BenK3nobi/Bmaps/VSR-V-1.0/drawing2.dxf

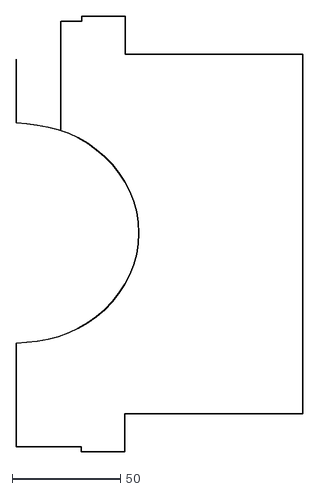
[picture p2: CAD file, 2019-07-29]
VSR-V-1.0/drawing2.dxf
132.3 x 200.8
