BenK3nobi/Bmaps/VSR-V-1.0/Holder/Holder.fcstd

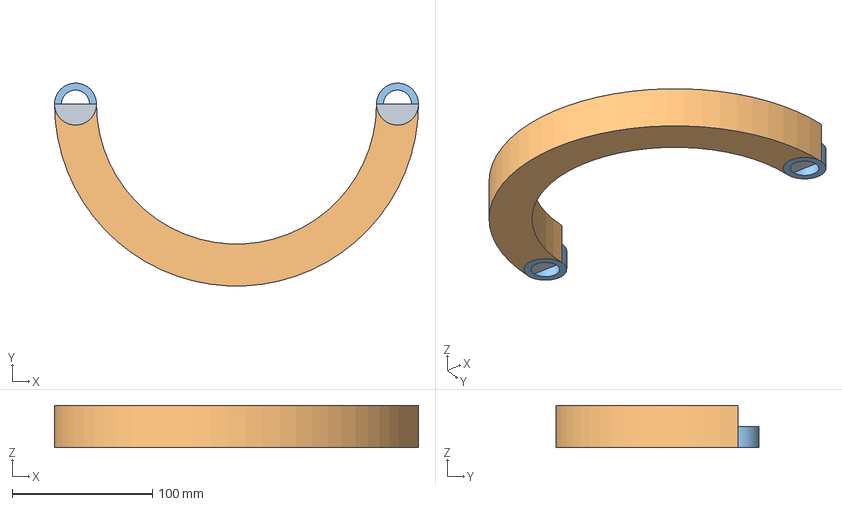
[picture p4: CAD file, 2019-07-29]
VSR-V-1.0/Holder/Holder.fcstd
260.0 x 144.8 x 30.0 mm
