BenK3nobi/Bmaps/(list of files, cad)

Other CAD files:
VSR-V-1.0/BoardStep.step
TESLA-V-1.0/BoardStep.step
TESLA-V-1.1/BoardStep.step
