BenK3nobi/Bmaps/VSR-V-1.0/AMR_3D_VSR_SingleCell.kicad_pcb

## KiCad design VSR-V-1.0/AMR_3D_VSR_SingleCell.kicad_pcb (2019-07-29)

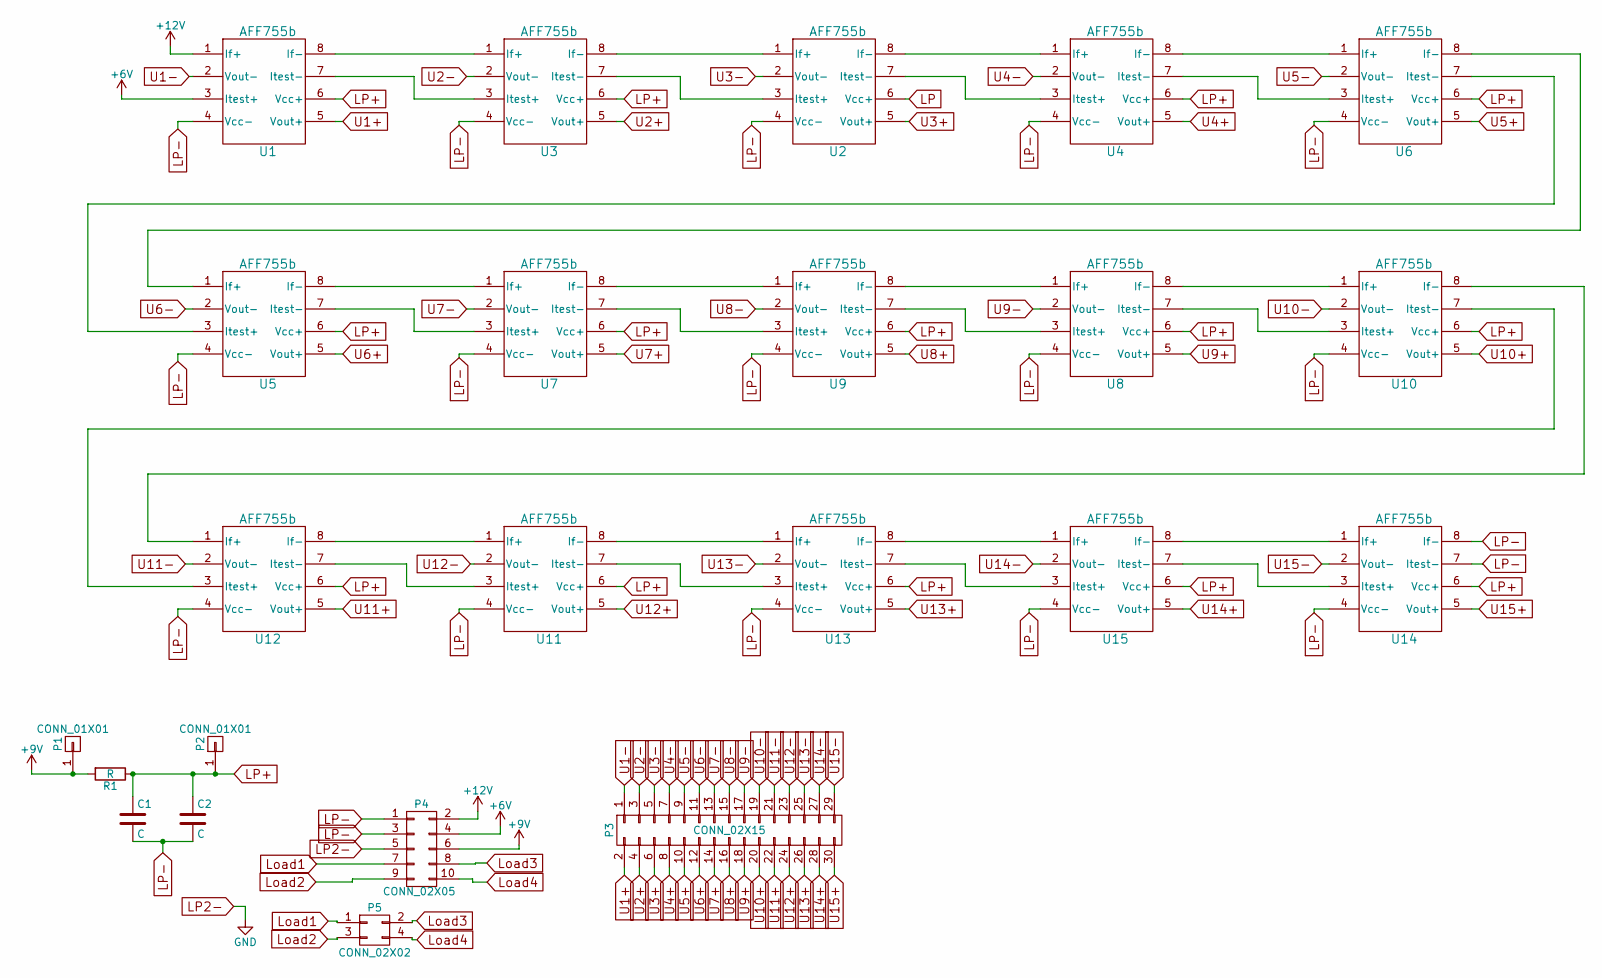
[picture p5: schematic AMR_3D_VSR_SingleCell.sch]

Parts:
C1, C2: C; SMD-2512_Pol
P1, P2: CONN_01X01; Pin_Header_Straight_1x01
P3: CONN_02X15; Multicomp_MC9A22-3434_2x17x2.54mm_Angled
P4: CONN_02X05; Multicomp_MC9A22-1034_2x05x2.54mm_Angled
P5: CONN_02X02; Pin_Header_Straight_2x02
R1: R; Resistor_Horizontal_RM10mm
U1, U2, U3, U4, U5, U6, U7, U8, U9, U10, U11, U12, U13, U14, U15: AFF755b; DIP-8_W7.62mm

Connections:
+6V: P4.4, U1.3 (Itest+)
+9V: P1.1, P4.6, R1.2
+12V: P4.2, U1.1 (If+)
Load1: P3.31, P4.7, P5.1; also elsewhere on the board
Load2: P3.33, P4.9, P5.3; also elsewhere on the board
Load3: P3.32, P4.8, P5.2; also elsewhere on the board
Load4: P3.34, P4.10, P5.4; also elsewhere on the board
unnamed: U1.7 (Itest-), U3.3 (Itest+)
unnamed: U1.8 (If-), U3.1 (If+)
unnamed: U2.1 (If+), U3.8 (If-)
unnamed: U2.3 (Itest+), U3.7 (Itest-)
unnamed: U2.7 (Itest-), U4.3 (Itest+)
unnamed: U2.8 (If-), U4.1 (If+)
unnamed: U4.7 (Itest-), U6.3 (Itest+)
unnamed: U4.8 (If-), U6.1 (If+)
unnamed: U5.1 (If+), U6.8 (If-)
unnamed: U5.3 (Itest+), U6.7 (Itest-)
unnamed: U5.7 (Itest-), U7.3 (Itest+)
unnamed: U5.8 (If-), U7.1 (If+)
unnamed: U7.7 (Itest-), U9.3 (Itest+)
unnamed: U7.8 (If-), U9.1 (If+)
unnamed: U8.1 (If+), U9.8 (If-)
unnamed: U8.3 (Itest+), U9.7 (Itest-)
unnamed: U8.8 (If-), U10.1 (If+)
unnamed: U8.7 (Itest-), U10.3 (Itest+)
unnamed: U10.7 (Itest-), U12.3 (Itest+)
unnamed: U10.8 (If-), U12.1 (If+)
unnamed: U11.1 (If+), U12.8 (If-)
unnamed: U11.3 (Itest+), U12.7 (Itest-)
unnamed: U11.7 (Itest-), U13.3 (Itest+)
unnamed: U11.8 (If-), U13.1 (If+)
unnamed: U13.7 (Itest-), U15.3 (Itest+)
unnamed: U13.8 (If-), U15.1 (If+)
unnamed: U14.1 (If+), U15.8 (If-)
unnamed: U14.3 (Itest+), U15.7 (Itest-)
U1+: P3.2, U1.5 (Vout+)
U1-: P3.1, U1.2 (Vout-)
U2+: P3.4, U3.5 (Vout+)
U2-: P3.3, U3.2 (Vout-)
U3+: P3.6, U2.5 (Vout+)
U3-: P3.5, U2.2 (Vout-)
U4+: P3.8, U4.5 (Vout+)
U4-: P3.7, U4.2 (Vout-)
U5+: P3.10, U6.5 (Vout+)
U5-: P3.9, U6.2 (Vout-)
U6+: P3.12, U5.5 (Vout+)
U6-: P3.11, U5.2 (Vout-)
U7+: P3.14, U7.5 (Vout+)
U7-: P3.13, U7.2 (Vout-)
U8+: P3.16, U9.5 (Vout+)
U8-: P3.15, U9.2 (Vout-)
U9+: P3.18, U8.5 (Vout+)
U9-: P3.17, U8.2 (Vout-)
U10+: P3.20, U10.5 (Vout+)
U10-: P3.19, U10.2 (Vout-)
U11+: P3.22, U12.5 (Vout+)
U11-: P3.21, U12.2 (Vout-)
U12+: P3.24, U11.5 (Vout+)
U12-: P3.23, U11.2 (Vout-)
U13+: P3.26, U13.5 (Vout+)
U13-: P3.25, U13.2 (Vout-)
U14+: P3.28, U15.5 (Vout+)
U14-: P3.27, U15.2 (Vout-)
U15+: P3.30, U14.5 (Vout+)
U15-: P3.29, U14.2 (Vout-)

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
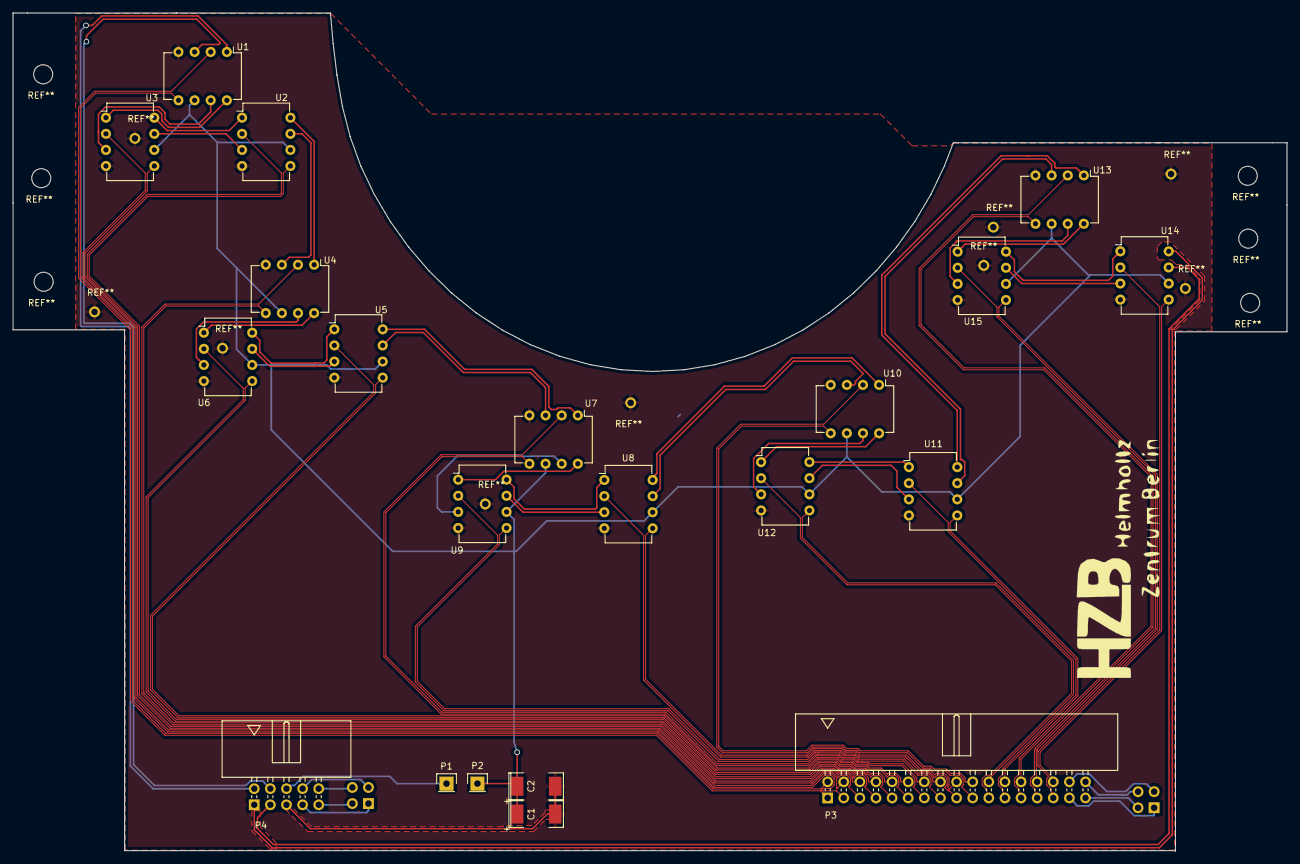
[picture p6: board AMR_3D_VSR_SingleCell.kicad_pcb from above]

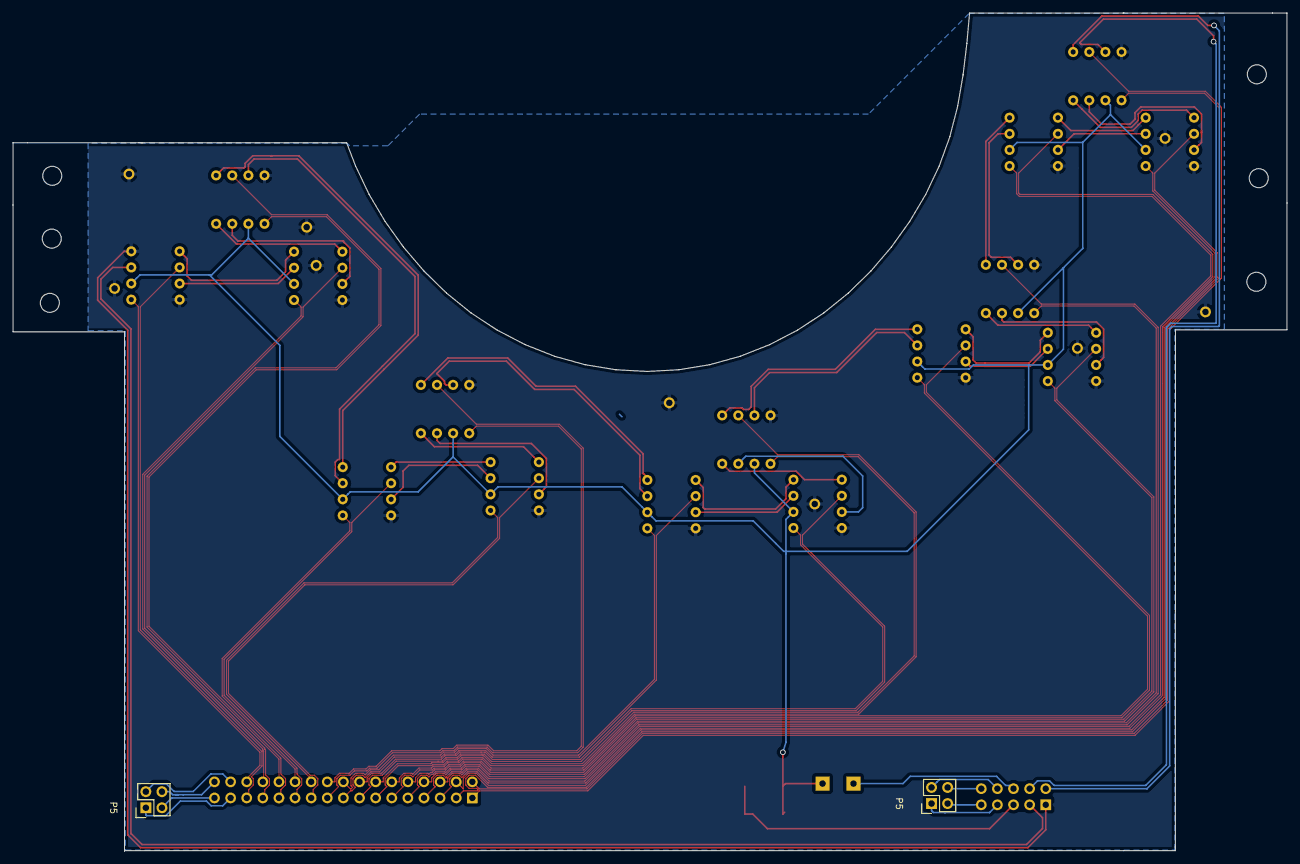
[picture p7: board AMR_3D_VSR_SingleCell.kicad_pcb from below]

Board: 2 copper layers, 200.8 x 132.1 mm, 23 parts (2 on the bottom side), 68 nets.

Other parts of the board:
P5#2: CONN_02X02; Pin_Header_Straight_2x02

Their connections:
Load1: P5#2.1; also elsewhere on the board
Load2: P5#2.3; also elsewhere on the board
Load3: P5#2.2; also elsewhere on the board
Load4: P5#2.4; also elsewhere on the board
