BenK3nobi/Bmaps/(commit log)

2018-02-22 All files for the Boards of Version 1 added and committed. Committer: Schmitz <ltu@basisit.de> On branch master Initial commit Changes to be committed: new file: AMR_3D_05_01_2017.zip new file: AMR_3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
    [AMR_3D_08_11_2016-B.Cu.gbl, AMR_3D_08_11_2016-B.Mask.gbs, AMR_3D_08_11_2016-B.Paste.gbp, AMR_3D_08_11_2016-B.SilkS.gbo, AMR_3D_08_11_2016-Cmts.User.gbr, AMR_3D_08_11_2016-Dwgs.User.gbr, AMR_3D_08_11_2016-Eco1.User.gbr, AMR_3D_08_11_2016-Eco2.User.gbr]
2018-02-22 Versio 0.9, Phi Sensors have a smaller pin distance.
    Committer: Schmitz <ltu@basisit.de>
    On branch master
    Initial commit
    Changes to be committed:
    new file: AMR_3D_08_11_2016-B.Adhes.gba
    new file: AMR_3D_08_11_2016-B.Cu.gbl
    new file: AMR_3D_08_11_2016-B.Mask.gbs
    new file: AMR_3D_08_11_2016-B.Paste.gbp
    new file: AMR_3D_08_11_2016-B.SilkS.gbo
    new file: AMR_3D_08_11_2016-Cmts.User.gbr
    new file: AMR_3D_08_11_2016-Dwgs.User.gbr
    new file: AMR_3D_08_11_2016-Eco1.User.gbr
    new file: AMR_3D_08_11_2016-Eco2.User.gbr
    new file: AMR_3D_08_11_2016-Edge.Cuts.gm1
    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
    [AMR_3D_08_11_2016-B.Cu.gbl, AMR_3D_08_11_2016-B.Mask.gbs, AMR_3D_08_11_2016-B.Paste.gbp, AMR_3D_08_11_2016-B.SilkS.gbo, AMR_3D_08_11_2016-Cmts.User.gbr, AMR_3D_08_11_2016-Dwgs.User.gbr, AMR_3D_08_11_2016-Eco1.User.gbr, AMR_3D_08_11_2016-Eco2.User.gbr]
2018-03-14 Initial Commit for the new version of smd boards. Committer: Schmitz <ltu@basisit.de> Changes to be committed: new file: AMR_3D_17_06_2017-cache.lib new file: AMR_3D_17_06_2017.kicad_pcb new file: AM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
    [AMR_3D_17_06_2017.kicad_pcb]
2018-03-14 Initial commit for VSR Singlecell BMap Board. Committer: Schmitz <ltu@basisit.de> Changes to be committed: new file: AMR_3D_VSR_SingleCell-cache.lib new file: AMR_3D_VSR_SingleCell.bak new file: AMR_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
    [AMR_3D_08_11_2016-B.Cu.gbl, AMR_3D_08_11_2016-B.Mask.gbs, AMR_3D_08_11_2016-B.Paste.gbp, AMR_3D_08_11_2016-B.SilkS.gbo, AMR_3D_08_11_2016-Cmts.User.gbr, AMR_3D_08_11_2016-Dwgs.User.gbr, AMR_3D_08_11_2016-Eco1.User.gbr, AMR_3D_08_11_2016-Eco2.User.gbr]
2018-03-14 Korrekte Ellipse für das VSR Shape eingefügt. Committer: Schmitz <ltu@basisit.de> Changes to be committed: modified: AMR_3D_VSR_SingleCell.kicad_pcb new file: drawing.dxf new file: drawing2.dxf
    [AMR_3D_VSR_SingleCell.kicad_pcb, drawing.dxf, drawing2.dxf]
2018-03-19 Introduced the shape for the boards in svg. Committer: Schmitz <ltu@basisit.de> Changes to be committed: modified: drawing.dxf new file: drawing.svg
    [drawing.dxf]
2018-03-19 New PCB Layout included, Routing of the signal channesl done. Committer: Schmitz <ltu@basisit.de> Changes to be committed: modified: AMR_3D_VSR_SingleCell.kicad_pcb modified: AMR_3D_VSR_SingleCell.ki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
    [AMR_3D_VSR_SingleCell.kicad_pcb, drawing2.dxf]
2018-03-19 Testspulen verdrahtet. Committer: Schmitz <ltu@basisit.de> Changes to be committed: modified: AMR_3D_VSR_SingleCell.kicad_pcb modified: AMR_3D_VSR_SingleCell.kicad_pcb-bak
    [AMR_3D_VSR_SingleCell.kicad_pcb]
2018-03-20 Filling of the Cu Plane fixed. Committer: Schmitz <ltu@basisit.de> Changes to be committed: modified: AMR_3D_VSR_SingleCell.kicad_pcb modified: AMR_3D_VSR_SingleCell.kicad_pcb-bak
    [AMR_3D_VSR_SingleCell.kicad_pcb]
2018-03-20 HZB Logo added to library and to the PCB. Committer: Schmitz <ltu@basisit.de> Changes to be committed: modified: AMR_3D_VSR_SingleCell.kicad_pcb modified: AMR_3D_VSR_SingleCell.kicad_pcb-bak modified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
    [AMR_3D_VSR_SingleCell.kicad_pcb]
2018-03-21 Adjusted length of the steps of the pcb. Committer: Schmitz <ltu@basisit.de> Changes to be committed: modified: AMR_3D_VSR_SingleCell.kicad_pcb modified: AMR_3D_VSR_SingleCell.kicad_pcb-bak
    [AMR_3D_VSR_SingleCell.kicad_pcb]
2018-03-21 Drillholes + additional load included. Committer: Schmitz <ltu@basisit.de> Changes to be committed: modified: AMR_3D_VSR_SingleCell.kicad_pcb modified: AMR_3D_VSR_SingleCell.kicad_pcb-bak
    [AMR_3D_VSR_SingleCell.kicad_pcb]
2018-03-21 Leiterbahn für die zusätlich load korrigiert. Committer: Schmitz <ltu@basisit.de> Changes to be committed: modified: AMR_3D_VSR_SingleCell.kicad_pcb modified: AMR_3D_VSR_SingleCell.kicad_pcb-bak
    [AMR_3D_VSR_SingleCell.kicad_pcb]
2019-07-29 Additional folder included.
    [AMR_3D_08_11_2016-B.Cu.gbl, AMR_3D_08_11_2016-B.Mask.gbs, AMR_3D_08_11_2016-B.Paste.gbp, AMR_3D_08_11_2016-B.SilkS.gbo, AMR_3D_08_11_2016-Cmts.User.gbr, AMR_3D_08_11_2016-Dwgs.User.gbr, AMR_3D_08_11_2016-Eco1.User.gbr, AMR_3D_08_11_2016-Eco2.User.gbr]
2019-07-29 Aditional folder inserted.
    [AMR_3D_08_11_2016-B.Cu.gbl, AMR_3D_08_11_2016-B.Mask.gbs, AMR_3D_08_11_2016-B.Paste.gbp, AMR_3D_08_11_2016-B.SilkS.gbo, AMR_3D_08_11_2016-Cmts.User.gbr, AMR_3D_08_11_2016-Dwgs.User.gbr, AMR_3D_08_11_2016-Eco1.User.gbr, AMR_3D_08_11_2016-Eco2.User.gbr]
2019-07-29 Initialiasation of the correct files.
    [AMR_3D_08_11_2016-B.Cu.gbl, AMR_3D_08_11_2016-B.Mask.gbs, AMR_3D_08_11_2016-B.Paste.gbp, AMR_3D_08_11_2016-B.SilkS.gbo, AMR_3D_08_11_2016-Cmts.User.gbr, AMR_3D_08_11_2016-Dwgs.User.gbr, AMR_3D_08_11_2016-Eco1.User.gbr, AMR_3D_08_11_2016-Eco2.User.gbr]
